Cryptoblade9623/Digital-Clock/README.md

# Digital-Clock
This is a digital clock that reflects the actual time in real life without you having to set it again.
It measures 30 x 85 x 85mm, so it is quite a compact device.
It does this by using a DS3231 module backed up by a CR2032 coin battery.
The time is displayed through a 7 segment 4 digit TM1637 module and a ring of WS2812B RGB lights that show the seconds.
It is powered by a 2000Mah battery with a J5019 charging and boost module and can be turned on and off with a 3 pin rocker switch.
It is a starter project from the [Half-Life YSWS](https://halflife.hackclub.com/dashboard).
I have changed it up by making it a fusion of 2 projects, using a different MCU and battery powering it.
The files include: 3D models of the case and PCB incase you want to make it yourself, PCB and schematics, BOM, firmware and gerber files.

## Pictures
Below are screenshots of the PCB, schematics, PCB rendering and case in Fusion 360.






## BOM
| Item | Qty | Supplier | Cost/item | Total Cost | link |
|---|-----|---|---|---|---|
| Waveshare RP2040 - Zero | 1 | AliExpress | $2.51 | $2.51 | https://www.aliexpress.com/item/1005005108143219.html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 |
| 2000Mah Battery | 1 | AliExpress | $5.99 | $5.99 | https://www.aliexpress.com/item/1005005614561610.html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 |
| J5019 Module | 1 | AliExpress | $1.37 | $1.37 | https://www.aliexpress.com/item/1005007352322912.html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  |
| DS3231 Module | 1 | AliExpress | $1.56 | $1.56 | https://www.aliexpress.com/item/1005013442131879.html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 |
| TM1637 Module | 1 | AliExpress | $1.21 | $1.21 | https://www.aliexpress.com/item/1005008658129354.html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 |
| WS2812B RGB Lights | 1 | AliExpress | $1.57 | $1.57 | https://www.aliexpress.com/item/1005001376489095.html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 |
| 100nF Capcitors | 1 | AliExpress | $1.28 | $1.28 | https://www.aliexpress.com/item/1005007533532838.html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 |
| 1000uF Capacitor + Shipping | 1 | Alibaba | $0.49 | $0.49 | https://www.alibaba.com/product-detail/SeekEC-35v-1000uf-Imported-Electrolytic-Capacitor_10000047487804.html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 |
| SN74AHCT1G125DBVR | 1 | AliExpress | $3.14 | $3.14 | https://www.aliexpress.com/item/1005006207262483.html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 |
| 330Ω Resistor | 1 | AliExpress | $1.04 | $1.04 | https://www.aliexpress.com/item/1005008971731418.html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 |
| Custom PCB ( Pack of 5 ) | 1 | JLCPCB | $4.00 | $4.00 | https://cart.jlcpcb.com/quote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 |
| Estimated total shipping | | | | $4.95 | |
| Grand Total | | | | $29.11 | |
