Cryptoblade9623/Digital-Clock/BOM.csv

Item | Qty | Supplier | Cost/item | Total Cost | link
Waveshare RP2040 - Zero | 1 | AliExpress | $2.51 | $2.51 | https://www.aliexpress.com/item/1005005108143219.html?curPageLogUid=s7GhyOkdsZ3a
2000Mah Battery | 1 | AliExpress | $5.99 | $5.99 | https://www.aliexpress.com/item/1005005614561610.html?scm_id=1007.40050.354490.0&scm-url=1007.40050.354490.0
J5019 Module | 1 | AliExpress | $1.37 | $1.37 | https://www.aliexpress.com/item/1005007352322912.html?scm_id=1007.40050.354490.0&scm-url=1007.40050.354490.0
DS3231 Module | 1 | AliExpress | $1.56 | $1.56 | https://www.aliexpress.com/item/1005013442131879.html
TM1637 Module | 1 | AliExpress | $1.21 | $1.21 | https://www.aliexpress.com/item/1005008658129354.html?curPageLogUid=1sDXgWB6cZBK
WS2812B RGB Lights | 1 | AliExpress | $1.57 | $1.57 | https://www.aliexpress.com/item/1005001376489095.html?curPageLogUid=Ney67dBOepAl
100nF Capcitors | 1 | AliExpress | $1.28 | $1.28 | https://www.aliexpress.com/item/1005007533532838.html?curPageLogUid=ygSORZkpai6h
1000uF Capacitor + Shipping | 1 | Alibaba | $0.49 | $0.49 | https://www.alibaba.com/product-detail/SeekEC-35v-1000uf-Imported-Electrolytic-Capacitor_10000047487804.html
SN74AHCT1G125DBVR | 1 | AliExpress | $3.14 | $3.14 | https://www.aliexpress.com/item/1005006207262483.html?curPageLogUid=3Hg7hSheoOGg
330Ω Resistor | 1 | AliExpress | $1.04 | $1.04 | https://www.aliexpress.com/item/1005008971731418.html?curPageLogUid=kHgK7Ns7Mhot
Custom PCB ( Pack of 5 ) | 1 | JLCPCB | $4.00 | $4.00 | https://cart.jlcpcb.com/quote?_t=1793396036865&up_spm=Jlcpcb.Loginpage.1003
Estimated total shipping | 1 |  |  | $4.95
