Cryptoblade9623/Digital-Clock/Files/3D Files/Clock_PCB.step

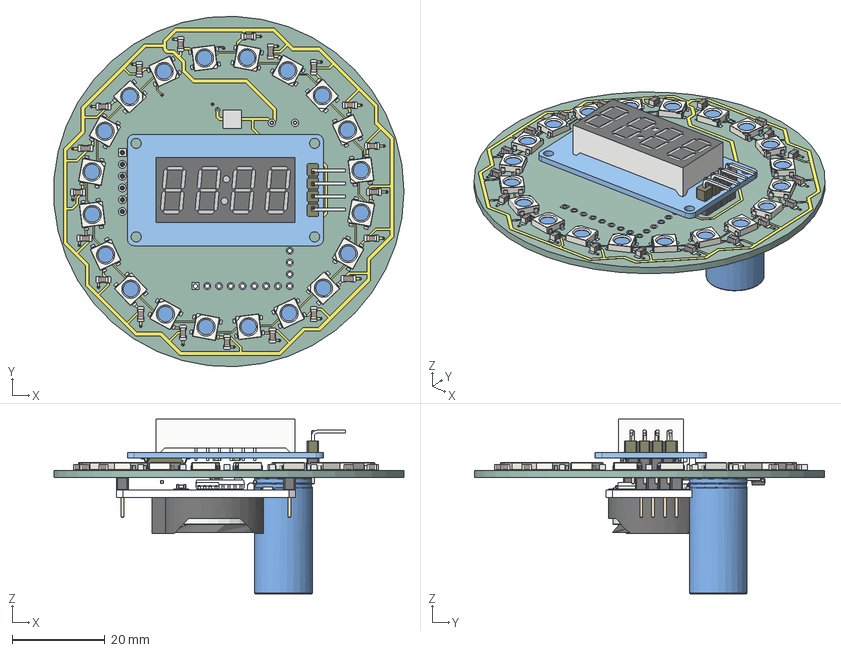
[picture p1: CAD file, 2026-10-30]
Files/3D Files/Clock_PCB.step
75.4 x 75.5 x 37.7 mm
C_0805_2012Metric x 22
LED_WS2812B_PLCC4_50x50mm_P32mm x 20
PinHeader_1x04_P254mm_Vertical x 2
Component1(Mirror)
Pin-out
PinHeader_1x06_P254mm_Vertical
SOT-23-5
R_1206_3216Metric
C_Radial_D125mm_H250mm_P500mm
CloE9FC_copper
CloE9FC_pad
CloE9FC_via
CloE9FC_PCB
