Cryptoblade9623/Digital-Clock/Files/3D Files/Clock.step

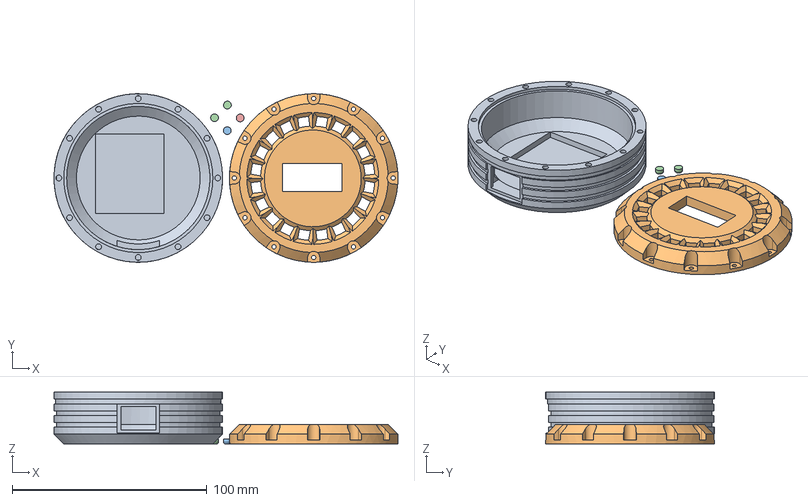
[picture p2: CAD file, 2026-10-30]
Files/3D Files/Clock.step
176.5 x 86.5 x 26.6 mm
