Cryptoblade9623/Digital-Clock/(list of files, cad)

Other CAD files:
Files/3D Files/Clock.f3z
Files/3D Files/Clock.stl
