Cryptoblade9623/Digital-Clock/Files/KiCad/Clock.kicad_pcb

## KiCad design Files/KiCad/Clock.kicad_pcb (2026-10-30)

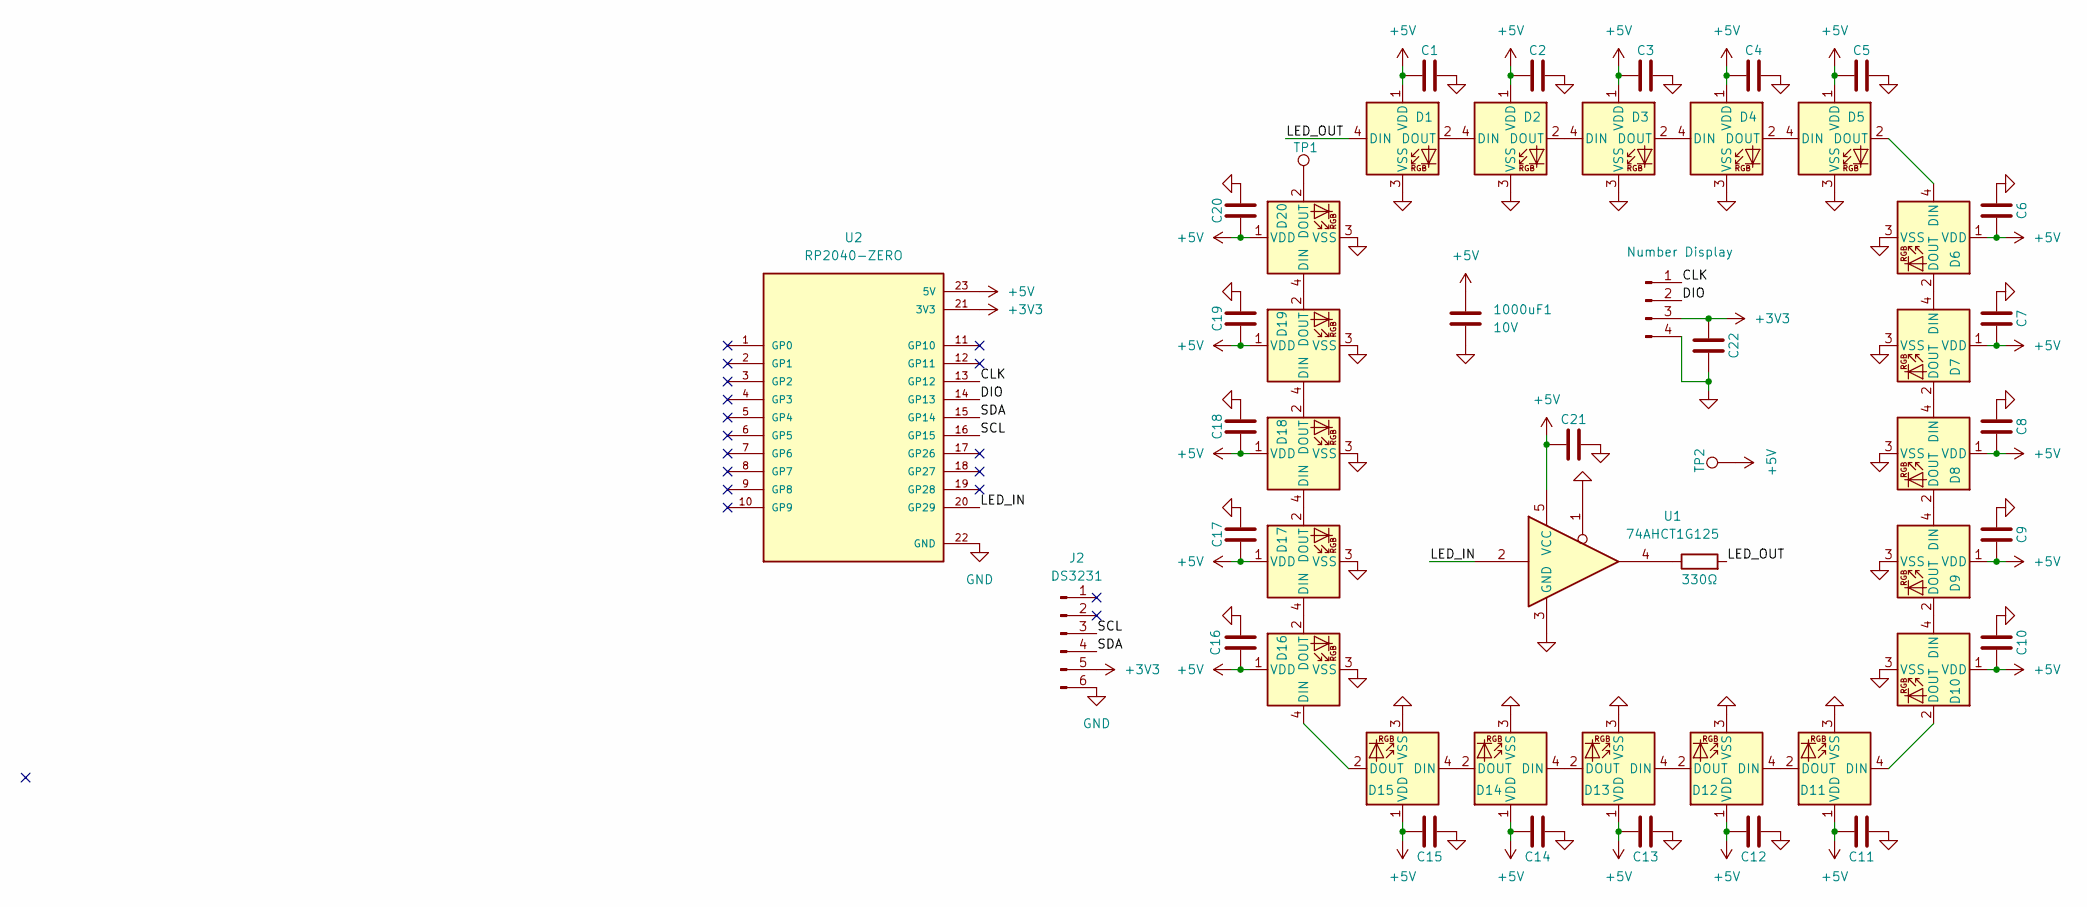
[picture p3: schematic Clock.kicad_sch]

Parts:
1000uF1: 10V; C_Radial_D12.5mm_H25.0mm_P5.00mm
C1, C2, C3, C4, C5, C6, C7, C8, C9, C10, C11, C12, C13, C14, C15, C16, C17, C18, C19, C20, C21, C22: C; C_0805_2012Metric_Pad1.18x1.45mm_HandSolder
D1, D2, D3, D4, D5, D6, D7, D8, D9, D10, D11, D12, D13, D14, D15, D16, D17, D18, D19, D20: WS2812B; LED_WS2812B_PLCC4_5.0x5.0mm_P3.2mm
J1: Number Display; TM1637_4PIN_Module
J2: DS3231; Untitled_1
R1: 330Ω; R_1206_3216Metric_Pad1.30x1.75mm_HandSolder
TP1, TP2: TestPoint; TestPoint_Pad_4.0x4.0mm
U1: 74AHCT1G125; SOT-23-5_HandSoldering
U2: RP2040-ZERO; MODULE_RP2040-ZERO; PARTREV NA

Connections:
+3V3: C22.1, J1.3, J2.5, U2.21 (3V3)
+5V: 1000uF1.1, C1.1, C2.1, C3.1, C4.1, C5.1, C6.2, C7.2, C8.2, C9.2, C10.2, C11.2, C12.2, C13.2, C14.2, C15.2, C16.2, C17.2, C18.2, C19.2, C20.2, C21.1, D1.1 (VDD), D2.1 (VDD), D3.1 (VDD), D4.1 (VDD), D5.1 (VDD), D6.1 (VDD), D7.1 (VDD), D8.1 (VDD), D9.1 (VDD), D10.1 (VDD), D11.1 (VDD), D12.1 (VDD), D13.1 (VDD), D14.1 (VDD), D15.1 (VDD), D16.1 (VDD), D17.1 (VDD), D18.1 (VDD), D19.1 (VDD), D20.1 (VDD), TP2.1 (1_1), U1.5 (VCC), U2.23 (5V)
/CLK: J1.1, U2.13 (GP12)
/DIO: J1.2, U2.14 (GP13)
/LED_IN: U1.2, U2.20 (GP29)
/LED_OUT: D1.4 (DIN), R1.2
/SCL: J2.3, U2.16 (GP15)
/SDA: J2.4, U2.15 (GP14)
GND: 1000uF1.2, C1.2, C2.2, C3.2, C4.2, C5.2, C6.1, C7.1, C8.1, C9.1, C10.1, C11.1, C12.1, C13.1, C14.1, C15.1, C16.1, C17.1, C18.1, C19.1, C20.1, C21.2, C22.2, D1.3 (VSS), D2.3 (VSS), D3.3 (VSS), D4.3 (VSS), D5.3 (VSS), D6.3 (VSS), D7.3 (VSS), D8.3 (VSS), D9.3 (VSS), D10.3 (VSS), D11.3 (VSS), D12.3 (VSS), D13.3 (VSS), D14.3 (VSS), D15.3 (VSS), D16.3 (VSS), D17.3 (VSS), D18.3 (VSS), D19.3 (VSS), D20.3 (VSS), J1.4, J2.6, U1.1, U1.3 (GND), U2.22 (GND)
unnamed: D1.2 (DOUT), D2.4 (DIN)
unnamed: D2.2 (DOUT), D3.4 (DIN)
unnamed: D3.2 (DOUT), D4.4 (DIN)
unnamed: D4.2 (DOUT), D5.4 (DIN)
unnamed: D5.2 (DOUT), D6.4 (DIN)
unnamed: D6.2 (DOUT), D7.4 (DIN)
unnamed: D7.2 (DOUT), D8.4 (DIN)
unnamed: D8.2 (DOUT), D9.4 (DIN)
unnamed: D9.2 (DOUT), D10.4 (DIN)
unnamed: D10.2 (DOUT), D11.4 (DIN)
unnamed: D11.2 (DOUT), D12.4 (DIN)
unnamed: D12.2 (DOUT), D13.4 (DIN)
unnamed: D13.2 (DOUT), D14.4 (DIN)
unnamed: D14.2 (DOUT), D15.4 (DIN)
unnamed: D15.2 (DOUT), D16.4 (DIN)
unnamed: D16.2 (DOUT), D17.4 (DIN)
unnamed: D17.2 (DOUT), D18.4 (DIN)
unnamed: D18.2 (DOUT), D19.4 (DIN)
unnamed: D19.2 (DOUT), D20.4 (DIN)
unnamed: D20.2 (DOUT), TP1.1 (1_1)
unnamed: R1.1, U1.4

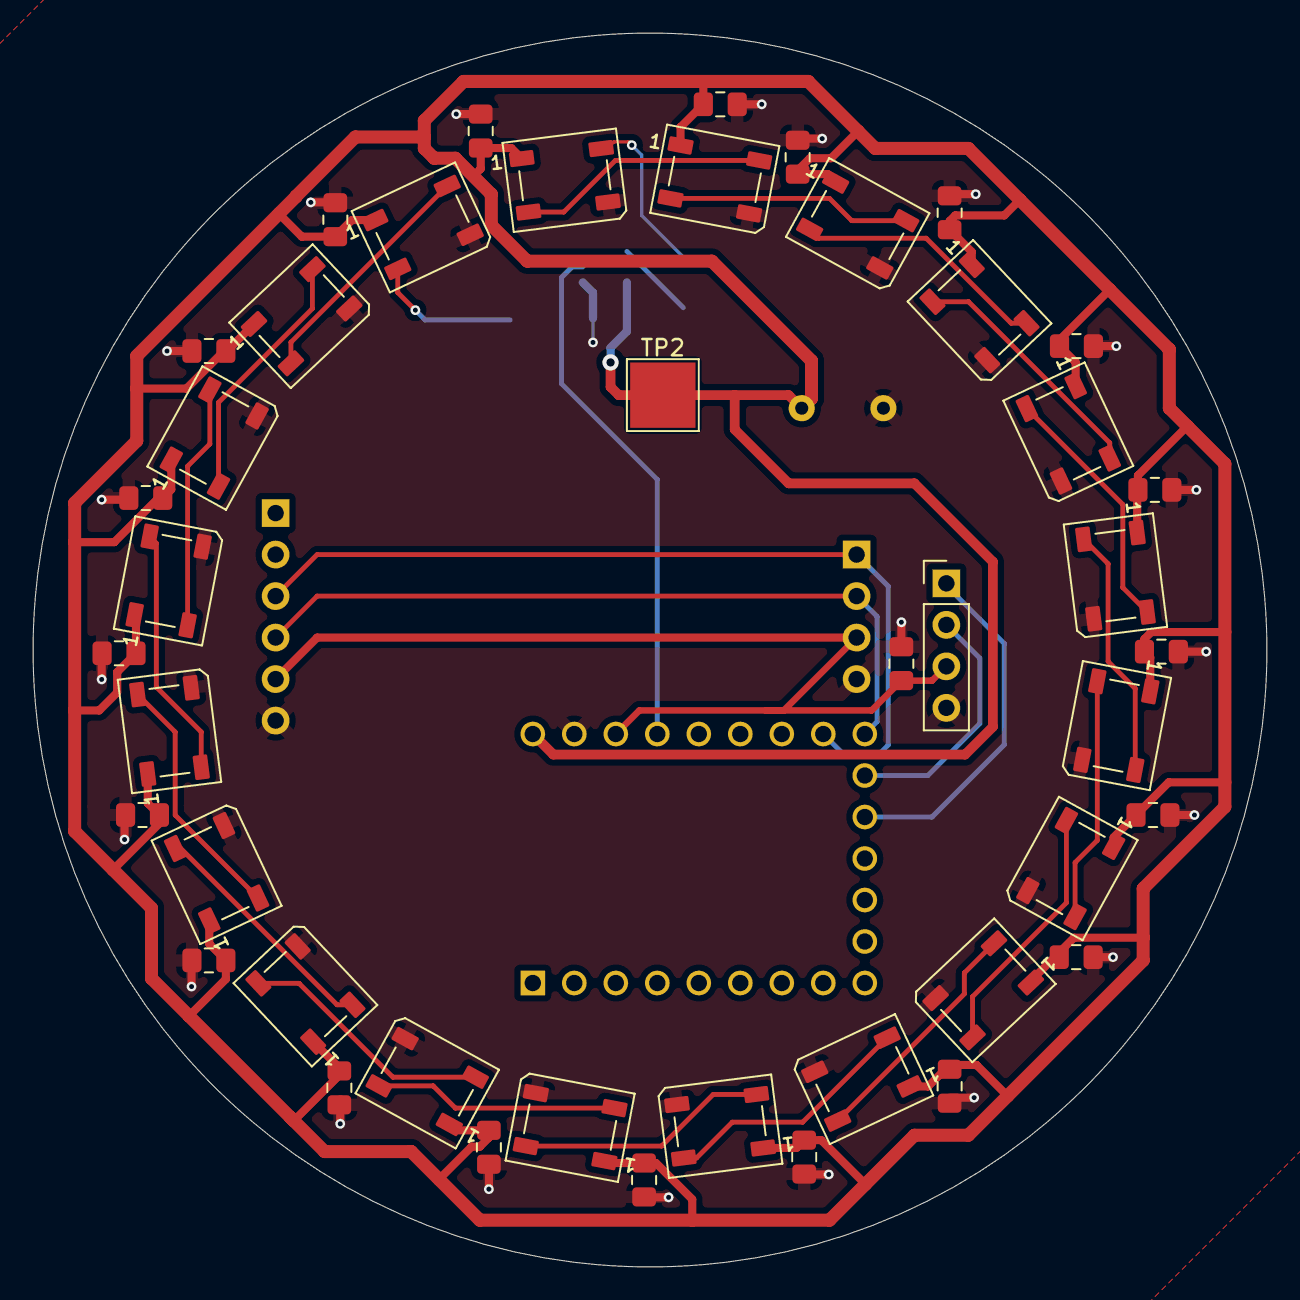
[picture p4: board Clock.kicad_pcb from above]

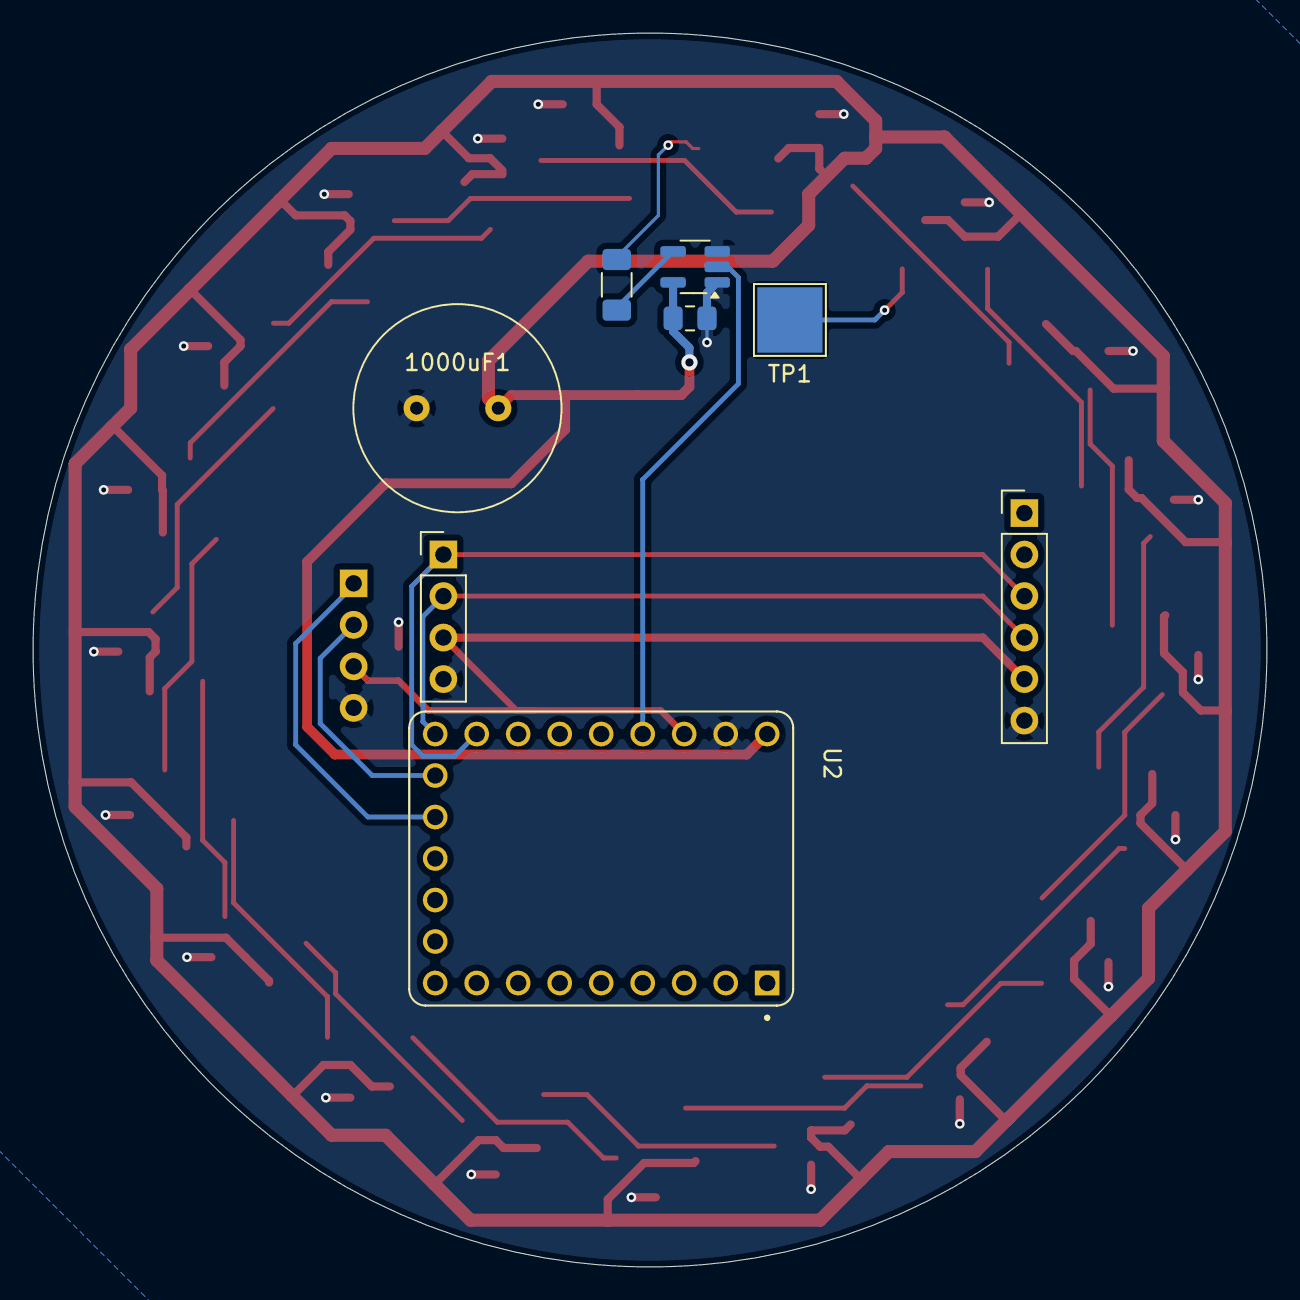
[picture p5: board Clock.kicad_pcb from below]

Board: 2 copper layers, 75.5 x 75.5 mm, 50 parts (7 on the bottom side), 30 nets.
