Cryptoblade9623/Digital-Clock/JOURNAL.md

# Digital Clock: devlog

<!-- Generated by Half Life from project m474vsc5jp8wa06vvug0uo38. Edits here are overwritten on the next sync. -->
<!-- Generated: 2026-10-30T21:59:42.020Z -->

> [!NOTE]
> This devlog is mirrored from [Half Life](https://halflife.hackclub.com) ([open the project](https://halflife.hackclub.com/projects/m474vsc5jp8wa06vvug0uo38)). Editing it here will not change the platform's copy, and the next sync overwrites this file.

> A digital clock with a 4 digit 7 segment display and a custom neopixel ring for the seconds hand. Battery powered and controlled by a Pi Pico. Made for design week 4 of Half-Life.

| Week | Tier | Hours logged | Entries |
| --- | --- | --- | --- |
| Week 4 | Tier 1 | 12.03h | 8 |

## Contents

1. [2026-10-27: Work session](#2026-10-27-work-session)
2. [2026-10-28: Work session](#2026-10-28-work-session)
3. [2026-10-29: Work session](#2026-10-29-work-session)
4. [2026-10-29: Just did some reading here mainly.](#2026-10-29-just-did-some-reading-here-mainly)
5. [2026-10-29: Work session](#2026-10-29-work-session)
6. [2026-10-30: I finished the code for the clock. This is added to the 1 and a half hours already logged in the "main" project in Hackatime because it wouldn't log that for some reason.](#2026-10-30-i-finished-the-code-for-the-clock-this-is-added-t)
7. [2026-10-30: Made changes to the case in Fusion: I added slots for the battery, power switch and charging module.](#2026-10-30-made-changes-to-the-case-in-fusion-i-added-slots-)
8. [2026-10-30: Work session](#2026-10-30-work-session)

## Design

### 2026-10-27: Work session

**2.62h**

[Timelapse](https://lookout.hackclub.com/api/media/f9b54892-bebf-45bb-bbd3-746d206de80f/video.mp4)

### 2026-10-28: Work session

**3.42h**

Work session

[Timelapse](https://lookout.hackclub.com/api/media/3f981209-8f90-45d0-adf0-49f3be75a111/video.mp4)

### 2026-10-29: Work session

**1.17h**

Work session

[Timelapse](https://lookout.hackclub.com/api/media/302d9d18-9b1c-4dbe-9931-582b5076acff/video.mp4)

[Timelapse](https://lookout.hackclub.com/api/media/949a353f-52f1-4ff0-8293-05d56b91e777/video.mp4)

[Timelapse](https://lookout.hackclub.com/api/media/8c3220e3-930c-4c94-b8d9-77ce67ff007a/video.mp4)

### 2026-10-29: Just did some reading here mainly.

**0.72h**

Just did some reading here mainly.

[Timelapse](https://lookout.hackclub.com/api/media/9e9db8bf-e9ce-4650-b593-f436af9e9f46/video.mp4)

### 2026-10-29: Work session

**0.43h**

[Timelapse](https://lookout.hackclub.com/api/media/f85f2123-59e9-4e85-b045-34df88021b49/video.mp4)

### 2026-10-30: I finished the code for the clock. This is added to the 1 and a half hours already logged in the "main" project in Hackatime because it wouldn't log that for some reason.

**2.5h**

I finished the code for the clock. This is added to the 1 and a half hours already logged in the "main" project in Hackatime because it wouldn't log that for some reason.
This took way longer than expected it to as I already had some basic knowledge of python code.
First I installed a bunch of different libraries into the micropico folder created by VS Code.

I referred to lots of online resources like Gemini,  https://docs.micropython.org/en/latest/library/neopixel.html and https://learn.adafruit.com/adafruit-neopixel-uberguide but the second didn't have anything useful on the coding part. Imported some modules at the start the reflect the libraries I had installed.

I then defined the pins.

And then initialize the neopixel,tm1637 and i2c connections.

I then received and converted the data from the ds3231 and translated it too inputs that my displays could understand.

I finished it with an np.write() statement and set the refresh rate to 25Hz.

### 2026-10-30: Made changes to the case in Fusion: I added slots for the battery, power switch and charging module.

**0.75h**

Made changes to the case in Fusion: I added slots for the battery, power switch and charging module.
I tried to keep the case as small as possible, so everything will be pressed together inside it, and then the 2 halves will be screwed together. I then arranged them into the places they will be printed in.



### 2026-10-30: Work session

**0.42h**

[Timelapse](https://lookout.hackclub.com/api/media/27b72a86-4011-42f9-9906-9fff878e12c0/video.mp4)
