Cryptoblade9623/Digital-Clock/(commit log)

2026-10-30 Update README with pictures and BOM section
    Added pictures and BOM section to README.
2026-10-30 Add BOM section with item details and links
    Added a Bill of Materials (BOM) section to the README with item details, suppliers, costs, and links.
